duskmoon314/ultrasonic_distance_meter/README.md

# ultrasonic_distance_meter

Design of Ultrasonic Distance Meter for THUEE Electronic Circuit Course Design

## About the report

You can find the template for the report here: [duskmoon314/THU_EXP](https://github.com/duskmoon314/THU_EXP)
